polcp03/epwt/01_plan/presentations/assets/photos/IMG_7300.jpg

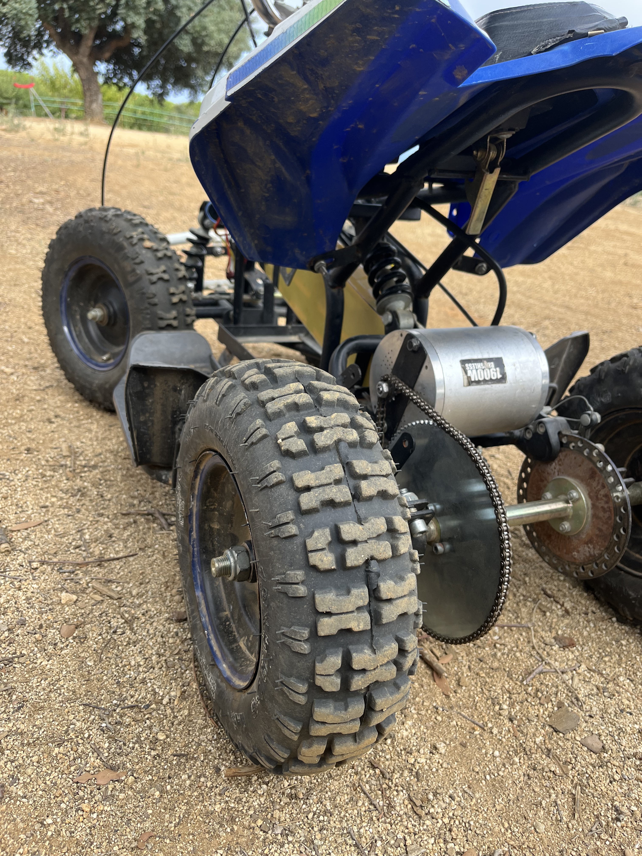
01_plan/presentations/assets/photos/IMG_7300.jpg
