polcp03/epwt/01_plan/presentations/assets/web/vesc_flipsky_1.jpg

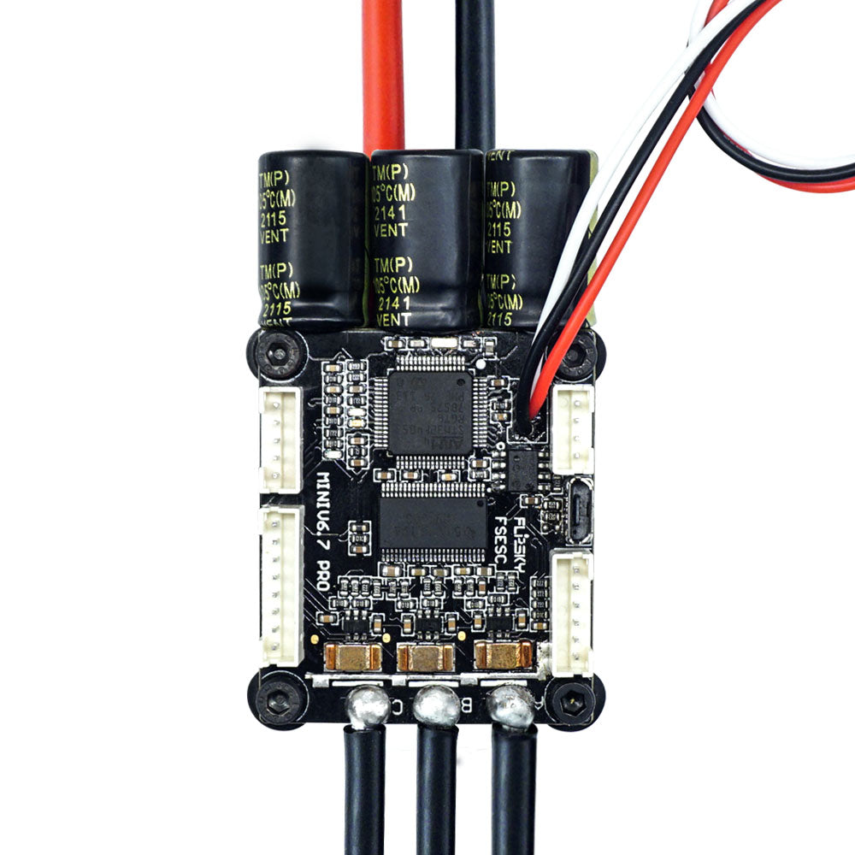
01_plan/presentations/assets/web/vesc_flipsky_1.jpg
