polcp03/epwt/01_plan/C00.md

# C00 — Kickoff con mentores

> [!todo] Pre-ciclo · 2 → 9 septiembre
> **No es un ciclo completo.** Son 8 días (~16 h) antes de las vacaciones.
> **Objetivo:** alinear a los mentores y llegar con algo físico ya medido.
> **Entregable:** reunión de 30 min, martes 8 o miércoles 9.

## Por qué existe este pre-ciclo

Te vas el 10 y vuelves el 27. Meter C01 entero antes es imposible, y partirlo por la
mitad con 2,5 semanas de hueco no es un ciclo: es un ciclo roto.

Así que C00 hace **una sola cosa**: dejar la relación con los mentores montada antes de
irte, para que el 28 de septiembre empieces a trabajar en vez de a organizarte.

> [!tip] Por qué medir algo, aunque sea poco
> Ir con un plan y nada más reproduce justo el patrón que quieres corregir.
> Con **una medida real**, la reunión cambia de "esto es lo que voy a hacer" a
> "esto es lo que ya he empezado". Es otra conversación.

## Plan

### Medir — 3 sesiones `[banco]`
- [x] **Pares de polos = 3** — conteo de pulsos Hall con LED (2026-09-06)
- [ ] ~~Resistencia de fase con multímetro (fase-fase ÷ 2)~~ → **no es viable**, ver abajo
- [x] Anotar en `03_hardware/`, marcado MEDIDO
- [x] **Back-EMF con osciloscopio** → λm = 16,86 mWb MEDIDO (2026-09-07)

> [!warning] Dos correcciones al plan original
> **El método de cogging para pares de polos era erróneo.** Las posiciones de cogging
> las fija la interacción entre ranuras del estátor e imanes del rotor —
> típicamente `mcm(ranuras, polos)` — no `p`. Habría dado un número plausible y falso.
> El conteo de pulsos Hall sí mide `p` por definición: una línea Hall da exactamente
> `p` ciclos por vuelta mecánica.
>
> **El `÷2` de la resistencia fase-fase sí era correcto**, confirmado leyendo el
> firmware: `foc_motor_r` es resistencia por fase. Pero el valor esperado
> (57,6 mΩ entre fases) está por debajo de lo que resuelve un multímetro normal,
> cuyas puntas ya valen 0,1–0,5 Ω. Necesita fuente de corriente conocida o
> miliohmímetro. Aparcada, no descartada.

### Preparar la reunión — 4 sesiones `[dirección]`
- [x] Presentación en inglés — 14 slides tras la poda del 8-sep
- [x] Qué es el proyecto y por qué existe
- [x] El plan: 6 ciclos, de aquí a diciembre, con fechas
- [x] **Qué espero de ellos** (ver abajo — es la slide que más importa)
- [x] Las medidas que ya tengo
- [x] Ensayar en voz alta con Claude de examinador

### Cerrar
- [x] Proponerles el 8 o el 9 → **presentado el 8**
- [ ] Confirmar la cadencia quincenal a partir del 12 de octubre
- [ ] Meter las 6 fechas de review en Google Calendar

## La slide que más importa: qué espero de ellos

Ellos mismos dijeron que aprenderían de ti. Eso está bien, pero puede diluir la
reunión en una charla técnica agradable y sin filo. Hay que pedirles explícitamente
lo que necesitas:

> [!quote] Lo que les pido
> 1. **Que me obliguen a una fecha.** Sin deadline externa, pospongo.
> 2. **Que ataquen mi razonamiento**, no el resultado. ¿La lógica se sostiene?
> 3. **Que detecten cuándo explico mal** porque no lo he entendido.
>
> Lo que NO les pido: validar FOC o control de motores eléctricos. Ese hueco lo cubro
> por otra vía, y decirlo abiertamente evita que se sientan evaluados en un dominio
> que no es el suyo.

## Fuera de alcance

Modelo, Simulink, firmware, campaña completa de medidas. Todo eso es C01, a partir
del 28 de septiembre.

---

## Bitácora

- **2026-09-02** — Infraestructura terminada (PR #2). Calendario aterrizado.
- **2026-09-03** — Detección FOC del VESC ejecutada: R=27,90 mΩ, L=106,49 µH,
  λm=16,07 mWb, sensores Hall. Ver [[motor-parameters]].
  **Hallazgo:** los pares de polos son desconocidos y los datos de mercado se
  contradicen (velocidad → p=3, par → p=4). Se mide con el ratio ERPM/RPM, sin desmontar.
- **2026-09-03** — Deck v1 generado y **rechazado por diseño genérico**. El contenido
  se conserva. Ver `presentations/README.md` para qué hace falta antes de rehacerlo.
- **2026-09-06** — Deck v2 construido y verificado con render (15 slides).
- **2026-09-06** — Auditoría completa del firmware y la configuración del VESC.
  **Resuelto por código:** `foc_motor_r` es resistencia **por fase** (no entre fases),
  y VESC usa las mismas ecuaciones dq que el bloque PMSM de Simulink. Se cierra la
  duda del factor 2 sin tocar el hardware. Parámetros extraídos a
  `04_model/params/` (`motor_params.m`, `vehicle_params.m`, `throttle_params.m`),
  validados en MATLAB.
  **Encontrado:** `si_gear_ratio` estaba en 1 en el equipo (debía ser 8,3636) →
  corregido. El motor no tiene sensor de temperatura, así que sus límites térmicos
  son código muerto → nuevo Riesgo 4 en [[open-questions]].
- **2026-09-06** — **`p = 3` MEDIDO.** Conteo de pulsos Hall con LED, girando la
  corona una vuelta: 25 destellos contra 25,1 predichos. Repetible.
  **Consecuencia:** la contradicción velocidad-vs-par queda resuelta, y en la
  dirección incómoda — los datos de mercado del MY1020/BM1109 **no son de este
  motor**. Con `Kt = 0,0721 N·m/A` harían falta 55 A para los 4 N·m "nominales".
  El deck (slide 10) todavía cuenta la contradicción como abierta: **hay que
  actualizarlo antes de la reunión.**
- **2026-09-08** — **Reunión hecha.** Deck auditado antes de presentar y podado de
  16 a 14 slides con el feedback de Pol. La auditoría encontró dos cosas que se
  habrían preguntado: un hallazgo de cabecera ("velocidad reportada un 28 % alta")
  que **contradecía el XML que citaba**, y una velocidad punta de 41 km/h que no
  existía en ningún sitio del repo. Las dos fuera.
  **Añadido:** la envolvente tenía dos techos y le faltaba el tercero — la
  restricción de tensión, que es la que la cierra en vacío. Las reglas de deck
  quedan en la skill `review-deck`.
  **Abierto:** las notas del VESC (`si_gear_ratio`, `si_motor_poles`) siguen sin
  cuadrar con `MOTOR_1.9.xml`. Pasa a C01 D1–D2, donde es un bloqueante.

## Cierre

**Resultado: la reunión salió bien y el pre-ciclo cumplió su único objetivo.**
Los mentores quedaron enganchados y quieren ver cómo evoluciona. Eso es
exactamente lo que C00 tenía que comprar: una relación abierta antes de las
vacaciones, para que el 28 de septiembre se empiece a trabajar y no a organizarse.

**Feedback de los mentores:** lo que más les gustó **no fueron las medidas, fue
el método** — cómo está organizado el proyecto, el ciclo de dos semanas, la
trazabilidad. Conviene leer eso con cuidado: son ingenieros de térmicos, no
pueden validar FOC, y el deck se lo decía. Lo que sí saben evaluar es si un
ingeniero trabaja de forma defendible. Que hayan mordido justo ahí significa que
el encuadre de la slide 13 funcionó.

**Consecuencia para C01:** si el sistema es lo que valoran, la review del 12 de
octubre tiene que enseñar el sistema **produciendo un resultado**, no el sistema
otra vez. La segunda vez, el método ya no impresiona: los números sí.

> [!todo] Pendiente de rellenar tras confirmar con ellos
> **Fecha de review #1 confirmada:** ___ (propuesta: lunes 12 de octubre)
> **Cadencia quincenal confirmada:** ___
> **Seis fechas en Google Calendar:** ___
>
> Es el único entregable de C00 que puede quedarse a medias, y el que más caro
> sale si se olvida: sin fecha externa, el ciclo pierde su mecanismo.
