polcp03/epwt/01_plan/C01.md

# C01 — Medir el vehículo

> [!todo] Ciclo activo · 28 sep → 11 oct · **Review: lunes 12 de octubre**
> **Objetivo:** cerrar el lado vehículo de `vehicle_params.m`.
> **Entregable:** los parámetros medidos, un coast-down escrito en `07_experiments/`,
> y la review.
> **Pregunta del ciclo:** *¿predice un modelo de fuerzas la deceleración real del quad?*
>
> 14 bloques × 2 h.

## Por qué este objetivo y no el que decía el roadmap

El roadmap ponía C01 como "caracterizar la planta: R, Ke, polos, vehículo".
**La mitad ya está hecha.** En C00 se midieron `p`, `λm`, `R`, `Ld/Lq`, `J` y el
arrastre del rotor, y tres métodos independientes coinciden en `λm` al 0,02 %.
La máquina es hoy la parte mejor caracterizada del quad.

El vehículo es la parte peor. `vehicle_params.m` lo dice sin adornos: el radio de
rodadura es una asunción, la masa una estimación, y `Crr`, `CdA`, `eta_drive` y
`R_int` son `NaN`. Su propio bloque de sensibilidad ordena el trabajo:

| Parámetro | Estado | Error en la aceleración predicha |
|---|---|---|
| `r_roll` | ASSUMED | ±6 % |
| `m_total` | ESTIMATED | ±5 % |
| `Crr` | MISSING | desconocido |
| `eta_drive` | MISSING | desconocido |
| `CdA` | MISSING | débil por debajo de 50 km/h |
| `J_rotor` | MEDIDO ±14 % | **±0,06 %** |

Una hora más en el motor compra menos que un minuto en el chasis. C01 va donde
está el error.

> [!tip] Y hay una razón de reunión, no solo de ingeniería
> Lo que engachó a los mentores en C00 **fue el método, no las medidas**.
> La segunda vez el método ya no impresiona. El 12 de octubre hay que enseñar el
> método **produciendo un número que antes no existía**.

---

## Antes de irte de vacaciones — opcional, 30 min

No es parte del ciclo. Pero son dos cosas que se hacen con el quad delante y sin
ordenador, y si están hechas el 28 de septiembre se arranca midiendo.

- [ ] Pesarte tú y pesar el quad. `m_driver = 72 kg` es una asunción sobre tu
      propia masa; es la más fácil de retirar del repo entero.
- [ ] Fotografiar la corona y el piñón contando dientes, para el archivo.

Si no te apetece, no pasa nada: D3 lo cubre.

---

## Semana 1 · Desbloquear y medir

### D1 — Abrir el ciclo `[dirección]`
- [ ] Leer el cierre de [[C00]]
- [ ] Confirmar las seis fechas de review en Google Calendar (si sigue pendiente)
- [ ] **Reconciliar la contradicción del VESC.** Tres sitios del repo dicen cosas
      distintas del mismo campo: [[C00]] dice que `si_gear_ratio` estaba en 1 y se
      corrigió, [[open-questions]] y `vehicle_params.m` dicen 6,5, y
      `MOTOR_1.9.xml` dice 8,363. **Manda el XML, no las notas.**

> [!danger] D2 bloquea todo lo que viene detrás
> El canal de velocidad del VESC alimenta cada log que C02 va a correlacionar.
> Si sale mal, se mide dos semanas de basura y no se descubre hasta noviembre.

### D2 — Arreglar la configuración del VESC `[banco]`
- [ ] Leer los tres campos en VESC Tool y compararlos con el XML del repo
- [ ] `si_motor_poles`: el XML dice **14**. Con `p = 3` MEDIDO debe ser **6**
- [ ] `si_wheel_diameter`: el XML dice **0,30 m**. Debe ser el diámetro de
      rodadura real, el que salga de D3
- [ ] `si_gear_ratio`: debe ser **8,3636**
- [ ] Re-exportar el XML a `03_hardware/vesc/` y **volver a leerlo** para verificar
- [ ] Corregir las notas del repo para que coincidan con el archivo

> [!question] Antes de tocar nada, calcula el error que arrastras
> La velocidad reportada es
> `(ERPM/(polos/2))/60 · π·d / i`. Con lo que hay hoy en el XML, ¿qué factor sale
> contra la realidad? ¿Y en qué dirección? Si no lo sabes calcular, los logs
> viejos de `06_data/` no se pueden rescatar; si lo sabes, sí.

### D3 — Geometría y masas `[banco]`
- [ ] **Roll-out de `r_roll`**: 10 vueltas de rueda con conductor sentado,
      medir la distancia, `r = D/(10·2π)`. Es el número más apalancado del vehículo
- [ ] Masa del vehículo y masa del conductor, en báscula
- [ ] Batalla
- [ ] **Reparto estático de peso**, con una báscula bajo cada eje

> [!success] Lo que compra el reparto de peso
> Retira el `ASSUMED` de la slide del gear ratio. Hoy el argumento "estoy en el
> límite de agarre" se apoya en μ = 0,75 y 65 % trasero inventados. Con el reparto
> medido, media asunción desaparece — y la otra mitad (μ) se puede acotar el día
> que se mida una aceleración máxima real.

### D4 — El ensayo que decide C02 `[banco]`
- [ ] Coast-down corto registrando por USB. **Hipótesis:** sin par, sin corriente
      de fase, el USB no se corta
- [ ] Si aguanta → C02 se valida sin construir el logger, y C05 se queda donde está
- [ ] Si se corta → osciloscopio en D+/D− y en el raíl de 5 V durante una rampa,
      y el logger pasa a ser un bloqueante real, no una sospecha

> [!danger] Seguridad, antes de cualquier tirada
> Límite de corriente configurado en el VESC · temperatura del pack al terminar ·
> nunca cargar sin supervisión. El motor **no tiene sensor de temperatura**: sus
> límites térmicos son código muerto y no te van a proteger.

### D5 — Campaña de coast-down `[banco]`
- [ ] Superficie plana y conocida, sin viento, marcha libre desde velocidad punta
- [ ] **Ida y vuelta en el mismo tramo**, varias repeticiones
- [ ] Registrar velocidad y tiempo; anotar superficie, presión de neumáticos y
      temperatura

> [!question] Por qué ida y vuelta
> Piénsalo antes de leer la respuesta en ningún sitio: ¿qué dos errores
> sistemáticos cancela promediar las dos direcciones, y por qué ninguno de los dos
> se puede corregir después con los datos de una sola dirección?

### D6 — Inercia del vehículo sobre caballetes `[banco]`
- [ ] El mismo ensayo de deceleración que el rotor, pero con las ruedas montadas
- [ ] La inercia total es ~250× la del rotor, así que la deceleración dura
      minutos y el log a 15 Hz sobra — el problema que arruinó la medida del rotor
      desaparece solo

### D7 — ¿Sirven los datos? `[datos]`
- [ ] Cargar todo en Python y mirarlo **antes de ajustar nada**
- [ ] Si algo hay que repetir, aún quedan cuatro días de banco

> [!warning] Este día existe a propósito
> Es el día para descubrir que un ensayo está mal, no la semana que viene.
> Si sale que todo está bien, se recupera como holgura.

## Semana 2 · Ajustar, escribir y explicar

### D8 — `Crr` y `CdA` del coast-down `[datos]`
- [ ] Modelo: `m·dv/dt = −(Crr·m·g + ½·ρ·CdA·v²)`
- [ ] Ajustar los dos coeficientes a la vez
- [ ] **Dar el intervalo de confianza, no solo el valor**

> [!question] La pregunta que te van a hacer
> Por debajo de 50 km/h domina la rodadura. ¿Cómo de bien está determinado `CdA`
> con estos datos? Un ajuste que da un número sin decir cuánto se lo cree es un
> número que no se puede usar. Y si `CdA` sale mal condicionado, ¿es un fallo del
> ensayo o una propiedad del problema?

### D9 — `eta_drive` y `R_int` `[datos]`
- [ ] Rendimiento de cadena y rodamientos: qué parte de la deceleración es
      transmisión y qué parte es rodadura
- [ ] `R_int` de la batería, de la caída de tensión contra corriente en los logs
- [ ] `R_int` es lo que convierte un límite de corriente en una caída de tensión,
      que es lo que **de verdad** recorta el par disponible

### D10 — EXP-002, escrito `[datos]`
- [ ] Hipótesis → método → datos → conclusión → **limitaciones**
- [ ] En `07_experiments/`, mismo formato que EXP-001

### D11 — Cerrar `vehicle_params.m` `[modelo]`
- [ ] Cada valor con su etiqueta: MEASURED / ESTIMATED / ASSUMED / MISSING
- [ ] Actualizar el bloque de sensibilidad del final: **¿cuál es ahora el
      parámetro más apalancado que sigue sin medir?** Esa pregunta abre C02

### D12 — Deck C01 `[dirección]`
- [ ] Skill `review-deck` — las reglas ya están escritas, no reinventarlas
- [ ] Auditar cada número contra el repo antes de dar el deck por hecho

### D13 — Ensayo `[dirección]`
- [ ] En voz alta, sin apuntes
- [ ] Claude de examinador: la slide peor sostenida, y por qué ese método y no otro

### D14 — Cierre `[dirección]`
- [ ] Rellenar Resultado / Qué aprendí / Qué salió mal
- [ ] Objetivo de C02

**Review: lunes 12 de octubre.**

---

## Fuera de alcance, a propósito

**Simulink.** El modelo longitudinal es C02. Construirlo ahora significaría
alimentarlo con los `NaN` que este ciclo existe para rellenar, y un modelo
parametrizado con asunciones no se puede correlacionar contra nada — solo se
puede ajustar hasta que salga bonito, que es la forma más cara de no aprender.

Lo que cambiaría esto: que D4 salga mal **y** que la campaña de coast-down se
caiga entera. Entonces sobran días y sí tiene sentido adelantar el nivel 1 del
modelo con los parámetros que haya, marcados.

**Firmware, VCU, data logger.** C05, salvo que D4 demuestre que el USB no
aguanta. Ver [[roadmap]].

---

## Bitácora

- **2026-09-08** — Ciclo reescrito tras la review de C00. El objetivo original
  ("caracterizar la planta") estaba a medio hacer antes de empezar: la máquina se
  cerró en C00, así que C01 apunta entero al vehículo.

## Cierre
_(en D14)_ **Resultado:** · **Qué aprendí:** · **Qué salió mal:**
