polcp03/epwt/02_knowledge/README.md

# 02_knowledge — lo que sé, no lo que he leído

Aquí no se copia teoría: la teoría está en los libros y en las lecciones. Aquí queda
**lo que yo sé explicar**, sacado de mis respuestas en los artifacts y corregido.

| Archivo | Qué es | Quién escribe |
|---|---|---|
| `motor-inversor.md` (y uno por tema) | Mis explicaciones, en mis palabras, ya corregidas | Claude copia de mis respuestas; yo reescribo lo que no me suene a mí |
| `errores.md` | Cada fallo que he tenido, con la versión correcta y cuándo volver a preguntármelo | Claude, al corregir |
| `fuentes.md` | Qué libro y qué capítulo para cada tema | Claude |
| `_metodo/` | Herramientas: Git, sesiones de Claude Code | — |

**Cómo se usa:**
1. Contesto en el artifact.
2. Claude corrige (skill `corregir`) y pasa aquí lo que ha quedado bien dicho y los errores.
3. Antes de cada examen, Claude me vuelve a preguntar los errores pendientes de `errores.md`.
   Un error se cierra cuando lo contesto bien **dos veces, en días distintos**.
