polcp03/epwt/01_plan/C02.md

# C02 — Motor + inversor: modelar y saber explicarlo

> [!todo] Ciclo activo · 21 → 30 oct · **Review: viernes 30 de octubre**
> **Pregunta del ciclo:** ¿cómo convierte mi quad 52 V de continua en par en la rueda, y qué lo limita?
> **Solo modelo.** Teoría, dibujos, casos prácticos y exámenes. El vehículo y el VESC no se tocan.
> **Presupuesto (desde 25-oct):** 45–60 min, martes a jueves. Lunes libre (idiomas), viernes de review.

## Dónde está todo

Qué toca cada día: tabla de [START-HERE](../START-HERE.md) y Google Calendar.

| Qué | Dónde |
|---|---|
| L1 · De la batería al par (mar 27) | [lección](https://claude.ai/artifact/F5pNX14PcUEVxtYv8zrwpN) · fuente `C02/L1-bateria-a-par.html` |
| L2 · El campo que gira (mié 28) | [lección](https://claude.ai/artifact/Fxcfde7icEog8iBLodXWTp) · fuente `C02/L2-campo-giratorio.html` |
| L3 · El modelo dq → **pasa a C03** | [lección](https://claude.ai/artifact/ARbJuhTgaTx9dbkfBe4dUh) · fuente `C02/L3-modelo-dq.html` |
| L4 · Tu motor en Simulink → **pasa a C03** | [lección](https://claude.ai/artifact/RYEtSwu3c9AVZad3iw57ZD) · fuente `C02/L4-simulink.html` |
| Examen final de L1+L2 (jue 29) | [C02 · Examen final](https://claude.ai/artifact/2o9NrZ6BgGsVTbg18AX3rZ) · fuente `C02/examen-final.html` |
| Examen original (referencia) | [Examen 1 — Motor eléctrico e inversor](https://claude.ai/code/artifact/764c1e7e-50fc-4bae-b8a6-3b19291b6242), sin cambios |

Formato desde el 25-oct (≈ 55 min): **predice** → **núcleo** de 6 ideas → **laboratorio**
(máx. 2 interactivos) → **criterio** (caso + "encuentra el error") → **cierre** en voz y
"qué no tengo claro". Cada pregunta tiene su cuadro: escribes, guardas y solo entonces se
abre la solución. Las respuestas quedan en la db del artifact (`answers/<lección>-<q>`) y
Claude las corrige. El material largo anterior queda en un anexo plegado; las versiones
viejas, en `C02/_old/`.

## Entregable de la review

1. Explicar de la batería al par sin apuntes.
2. **Número nuevo:** se elige el jueves 29 al acordar las slides.
3. Lo que no entiendo.

~~Modelo dq en Simulink~~ → C03 (replan del 25-oct).

## Después de C02 (dirección, no plan)

C03 inversor + lazo de corriente → data logger → validación con datos reales.
Sin logger no hay datos, y sin datos no se valida. Fechas en [roadmap](roadmap.md).

## Bitácora

- **2026-10-20** — Ciclo abierto. C01 cerrado (review hecha, gustó). Nueva forma de
  trabajar: Pol decide el rumbo, una tarea visible cada 2–3 días, Claude filtra el
  20 % clave de los libros y lo convierte en lecciones con visuales y exámenes.
  Plan y 4 lecciones publicados.
- **2026-10-20 (tarde)** — Revisión completa. Arreglado un fallo que dejaba los gráficos
  en blanco en el móvil (alturas que crecían con la densidad de pantalla). Añadidas una
  figura resumen por lección, un cierre en voz cada día de teoría y un examen final
  propio de C02. Plan reequilibrado a ≤ 90 min por día; el deck lo monta Claude el 29
  por la tarde a partir de la lista de slides acordada.
- **2026-10-21** — Teoría rehecha tras releer Hughes: L1 con las 10 leyes de memoria
  (Ohm/Kirchhoff, Ampère, circuito magnético, Lorentz/Fleming, Faraday, Lenz,
  inductancia, energía, Newton, saturación) y 8 pasos ilustrados; L2 con los 6
  conceptos de alterna (senoide, fasor, RMS, trifásica, √3, polos) y 8 pasos con
  dibujo; L3 con dibujos de Park, circuitos dq y límites. En todas: autocomprobación
  por paso, ejemplo resuelto y otro para ti, y repaso espaciado de la lección anterior.

- **2026-10-25** — Replan. Pol va por L1 cuando tocaba L3: las lecciones eran largas, la
  solución estaba a la vista y nadie le pedía cuentas. Decisiones: máster sentado con el
  PC (se descarta móvil/voz), 45–60 min de martes a jueves, lunes libre, sábado un
  ejercicio, domingo descanso. L1 y L2 rehechas más cortas con cuadros de respuesta que
  ocultan la solución; examen final reducido a L1+L2 (45 min). L3, L4 y teoría de
  control pasan a C03. Todo en Google Calendar, a las 07:00.

## Cierre
_(el 30)_ **Resultado:** · **Qué aprendí:** · **Qué salió mal:**
