polcp03/epwt/01_plan/presentations/assets/photos/IMG_7239.jpg

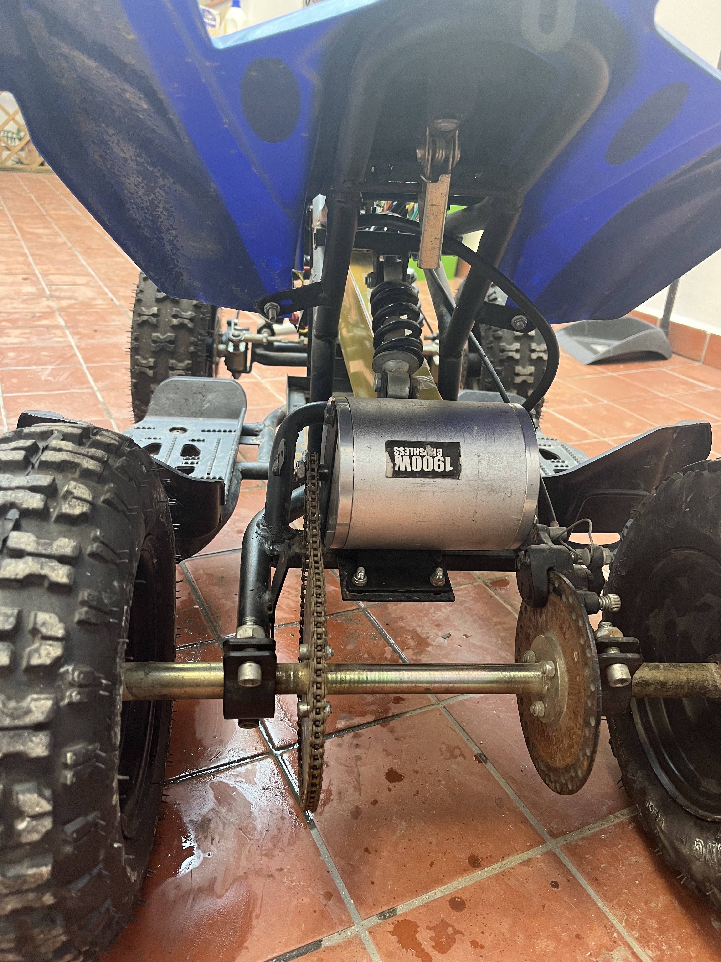
01_plan/presentations/assets/photos/IMG_7239.jpg
