polcp03/epwt/01_plan/presentations/assets/web/vesc_flipsky_2.jpg

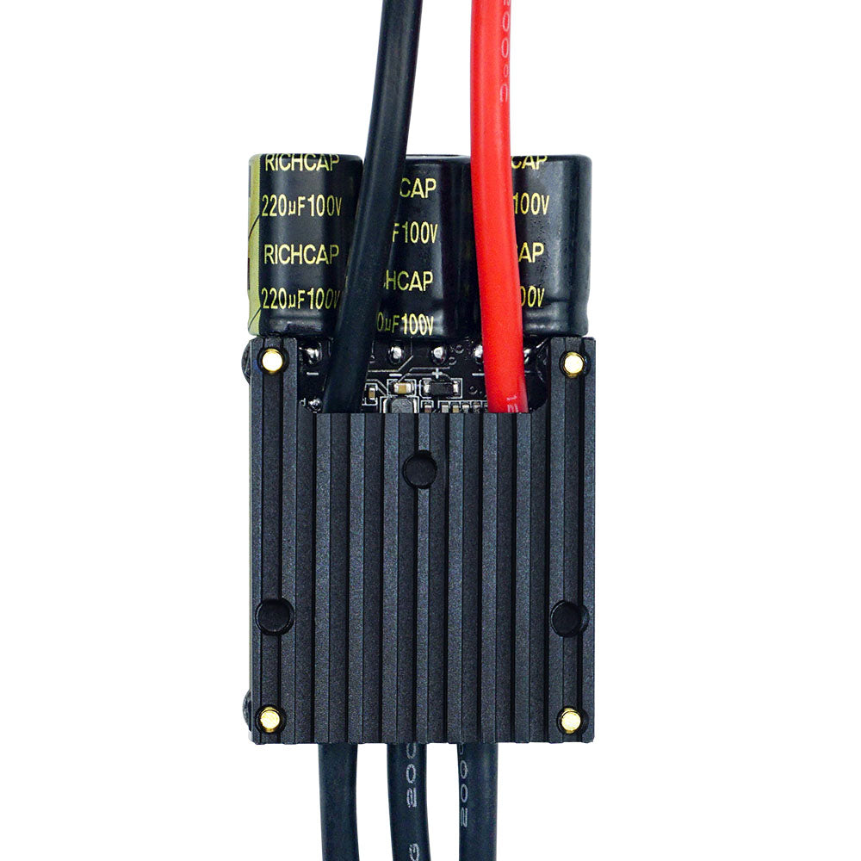
01_plan/presentations/assets/web/vesc_flipsky_2.jpg
