polcp03/epwt/03_hardware/vesc/screenshots/foc-detection_2026-07-29.png

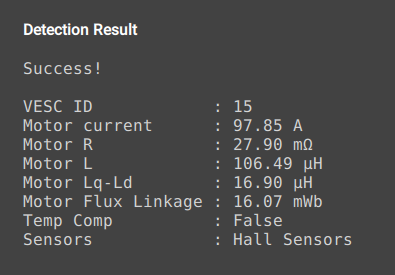
03_hardware/vesc/screenshots/foc-detection_2026-07-29.png
