polcp03/epwt/04_model/results/C01_predictions_table.md

<!-- generated by scripts/run_predictions_L1.m on 2026-10-09 10:38 -->

Nominal at V_oc = 50.0 V, m_total = 110 kg.

| Prediction | Nominal | Band (RSS) | Dominant parameter | V_oc 46 / 54 V |
|---|---|---|---|---|
| Top speed [km/h] | 34.2 | +/- 1.2 | r_roll (65 % of variance) | 31.4 / 36.9 |
| Time 0-25 km/h [s] | 2.8 | +/- 0.5 | mu (60 % of variance) | 3.0 / 2.7 |
| Coast-down 30-5 km/h [s] | 17.2 | +/- 5.6 | Crr (96 % of variance) | 17.2 / 17.2 |
| Speed where 40 A battery limit kicks in [km/h] | 9.0 | +/- 0.6 | R_int (68 % of variance) | 7.9 / 10.2 |

### One-at-a-time detail (low / high end of each range)

| Parameter | Range | Top speed | t 0-25 | Coast 30-5 |
|---|---|---|---|---|
| r_roll | 0.15 - 0.16 | 33.2 / 35.1 | 2.82 / 2.85 | 17.1 / 17.3 |
| Crr | 0.02 - 0.045 | 34.5 / 33.7 | 2.73 / 3.01 | 22.7 / 12.7 |
| CdA | 0.45 - 0.8 | 34.4 / 33.8 | 2.82 / 2.86 | 18.0 / 16.3 |
| eta_drive | 0.9 - 0.97 | 34.1 / 34.2 | 2.97 / 2.79 | 17.3 / 17.2 |
| mu | 0.45 - 0.75 | 34.2 / 34.2 | 3.22 / 2.77 | 17.2 / 17.2 |
| x_cg | 0.55 - 0.75 | 34.2 / 34.2 | 3.02 / 2.77 | 17.2 / 17.2 |
| m_rot_wheels | 2 - 8 | 34.2 / 34.2 | 2.78 / 2.93 | 16.9 / 17.8 |
| R_int | 0.06 - 0.15 | 34.6 / 33.9 | 2.77 / 2.93 | 17.2 / 17.2 |

Grip-limited at launch (nominal): true. Peak battery current (nominal): 40.0 A.
