polcp03/epwt/07_experiments/README.md

# Experiments

Un archivo por experimento: `EXP-001-nombre.md`. Hipótesis -> medida -> conclusión.

- **Pregunta:** qué quiero averiguar
- **Hipótesis:** qué espero que pase, y por qué
- **Método:** cómo lo mido
- **Datos:** qué obtuve (enlace a `data/`)
- **Conclusión:** confirma o refuta
- **Limitaciones:** qué no cubre esto
