polcp03/epwt/06_data/2026-09-07_inercia/2026-09-07_test_inercia.csv

ms_today | input_voltage | temp_mos_max | temp_mos_1 | temp_mos_2 | temp_mos_3 | temp_motor | current_motor | current_in | d_axis_current | q_axis_current | erpm | duty_cycle | amp_hours_used | amp_hours_charged | watt_hours_used | watt_hours_charged | tachometer | tachometer_abs | encoder_position | fault_code | vesc_id | d_axis_voltage | q_axis_voltage | ms_today_setup | amp_hours_setup | amp_hours_charged_setup | watt_hours_setup | watt_hours_charged_setup | battery_level | battery_wh_tot | current_in_setup | current_motor_setup | speed_meters_per_sec | tacho_meters | tacho_abs_meters | num_vescs | ms_today_imu | roll | pitch | yaw | accX | accY | accZ | gyroX | gyroY | gyroZ | gnss_posTime | gnss_lat | gnss_lon | gnss_alt | gnss_gVel | gnss_vVel | gnss_hAcc | gnss_vAcc
40417532 | 52.9 | 35.8 | 0 | 0 | 0 | 0 | 1.36 | 1.46 | 0 | 1.86 | 16448 | 0.949 | 0.032 | 0 | 1.6911 | 0.0005 | 81137 | 81597 | 169.115 | 0 | 15 | -3.186 | 28.751 | 40417316 | 0.032 | 0 | 1.6899 | 0.0005 | 0.881 | 468.745 | -1.46 | -2.23 | 4.413 | 217.417 | 218.652 | 1 | -1 | 0 | 0 | 0 | 0 | 0 | 0 | 0 | 0 | 0 | -1 | 0.00000000 | 0.00000000 | 0.00000000 | 0.00000000 | 0.00000000 | 0.00000000 | 0.00000000
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
