polcp03/epwt/04_model/results/C01_coast_curves.csv

t | nominal | r_roll_lo | r_roll_hi | Crr_lo | Crr_hi | CdA_lo | CdA_hi | eta_drive_lo | eta_drive_hi | mu_lo | mu_hi | x_cg_lo | x_cg_hi | m_rot_wheels_lo | m_rot_wheels_hi | R_int_lo | R_int_hi
0 | 30 | 30 | 30 | 30 | 30 | 30 | 30 | 30 | 30 | 30 | 30 | 30 | 30 | 30 | 30 | 30 | 30
0.1 | 29.7998606498511 | 29.798898450412 | 29.8007445985569 | 29.8337083106026 | 29.7490890336008 | 29.819346754281 | 29.77391870899 | 29.8009210490432 | 29.7994364953958 | 29.7998606498511 | 29.7998606498511 | 29.7998606498511 | 29.7998606498511 | 29.7963112008214 | 29.8066009322906 | 29.7998606498511 | 29.7998606498511
0.2 | 29.6008275621339 | 29.5989126960541 | 29.6025867816201 | 29.6683367692371 | 29.4995627559932 | 29.6394584865262 | 29.5494756425702 | 29.6029390405804 | 29.5999829914692 | 29.6008275621339 | 29.6008275621339 | 29.6008275621339 | 29.6008275621339 | 29.5937681233974 | 29.6142350867619 | 29.6008275621339 | 29.6008275621339
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
