polcp03/epwt/04_model/results/C01_coast_start.csv

v_start_kmh | t_nom | dt_CdA | dt_Crr
15 | 8.03999999999987 | 0.189999999999996 | 3.01999999999994
20 | 11.4899999999998 | 0.389999999999992 | 4.08999999999991
25 | 14.5499999999997 | 0.639999999999986 | 4.8800000000005
30 | 17.2199999999999 | 0.920000000000144 | 5.47000000000086
