polcp03/epwt/04_model/results/C01_envelope.csv

v_kmh | F_wheel | iq | I_bat | F_road | F_grip
0 | 0 | 0 | 0 | 32.373 | 420.849
0 | 0 | 0 | 0 | 32.373 | 420.849
0 | 0 | 0 | 0 | 32.373 | 420.849
0 | 0 | 0 | 0 | 32.373 | 420.849
0 | 0 | 0 | 0 | 32.373 | 420.849
0 | 0 | 0 | 0 | 32.373 | 420.849
0 | 0 | 0 | 0 | 32.373 | 420.849
0 | 0 | 0 | 0 | 32.373 | 420.849
0 | 0 | 0 | 0 | 32.373 | 420.849
0 | 0 | 0 | 0 | 32.373 | 420.849
0 | 0 | 0 | 0 | 32.373 | 420.849
0 | 0 | 0 | 0 | 32.373 | 420.849
0 | 0 | 0 | 0 | 32.373 | 420.849
0 | 0 | 0 | 0 | 32.373 | 420.849
0 | 0 | 0 | 0 | 32.373 | 420.849
0 | 0 | 0 | 0 | 32.373 | 420.849
0 | 0 | 0 | 0 | 32.373 | 420.849
0 | 0 | 0 | 0 | 32.373 | 420.849
0 | 0 | 0 | 0 | 32.373 | 420.849
0 | 0 | 0 | 0 | 32.373 | 420.849
0 | 0 | 0 | 0 | 32.373 | 420.849
0 | 0 | 0 | 0 | 32.373 | 420.849
0 | 0 | 0 | 0 | 32.373 | 420.849
0 | 0 | 0 | 0 | 32.373 | 420.849
0 | 0 | 0 | 0 | 32.373 | 420.849
0 | 0 | 0 | 0 | 32.373 | 420.849
0 | 0 | 0 | 0 | 32.373 | 420.849
0 | 0 | 0 | 0 | 32.373 | 420.849
0 | 0 | 0 | 0 | 32.373 | 420.849
0 | 0 | 0 | 0 | 32.373 | 420.849
0 | 0 | 0 | 0 | 32.373 | 420.849
0 | 0 | 0 | 0 | 32.373 | 420.849
0 | 0 | 0 | 0 | 32.373 | 420.849
0 | 0 | 0 | 0 | 32.373 | 420.849
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
