polcp03/epwt/04_model/results/C01_oat.csv

param | vtop_lo | vtop_hi | t025_lo | t025_hi | tcst_lo | tcst_hi
r_roll | 33.174077118365 | 35.1318280749878 | 2.81598472145789 | 2.85337141689965 | 17.1399999999999 | 17.2899999999999
Crr | 34.473465432653 | 33.6761519402646 | 2.73266758162944 | 3.01371217594468 | 22.6900000000007 | 12.6899999999998
CdA | 34.399318490011 | 33.8445572729282 | 2.8194305253054 | 2.86086170533314 | 18.01 | 16.2999999999997
eta_drive | 34.0538602382112 | 34.1990306082908 | 2.96654949341254 | 2.78913031987701 | 17.3199999999999 | 17.1799999999999
mu | 34.1597588386619 | 34.1597588386619 | 3.22094231549211 | 2.77081587330827 | 17.2199999999999 | 17.2199999999999
x_cg | 34.1597588386619 | 34.1597588386619 | 3.02005254931557 | 2.77081587330827 | 17.2199999999999 | 17.2199999999999
m_rot_wheels | 34.1597588386619 | 34.1597588386619 | 2.78462016862827 | 2.93085095329062 | 16.9199999999998 | 17.82
R_int | 34.5712030661931 | 33.8757794886776 | 2.77233151779194 | 2.92721387708987 | 17.2199999999999 | 17.2199999999999
NOMINAL | 34.1597588386619 | 34.1597588386619 | 2.84004286606908 | 2.84004286606908 | 17.2199999999999 | 17.2199999999999
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
