polcp03/epwt/04_model/results/back_emf_resultado.png

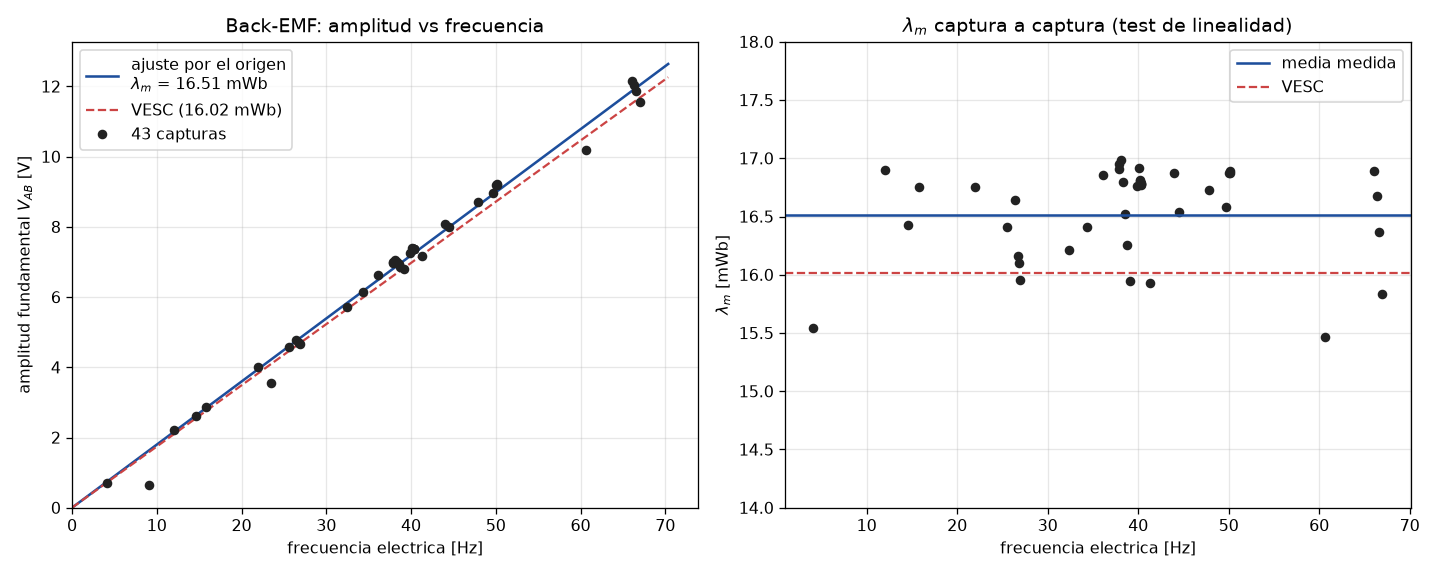
04_model/results/back_emf_resultado.png
