polcp03/epwt/04_model/results/back_emf_txt.png

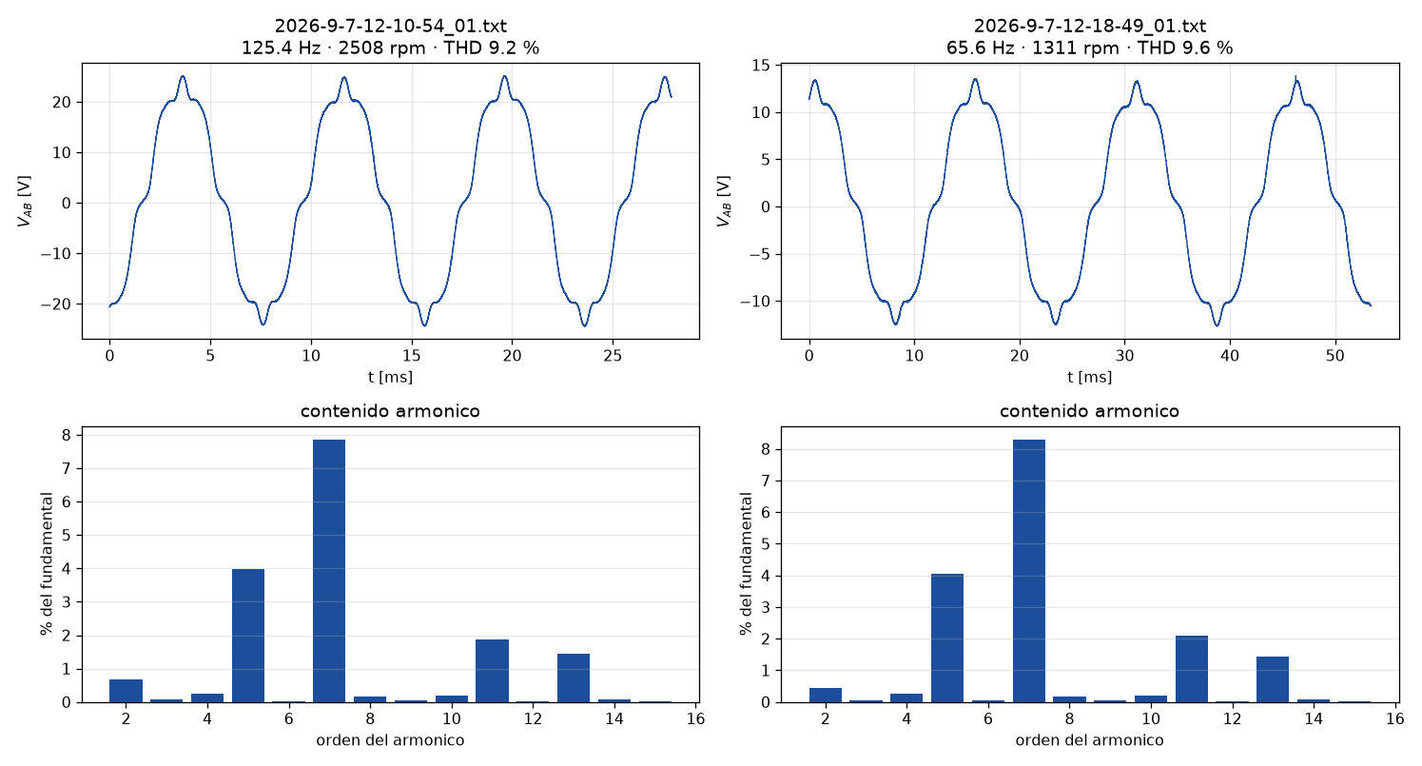
04_model/results/back_emf_txt.png
