polcp03/epwt/04_model/results/backemf_pasos.png

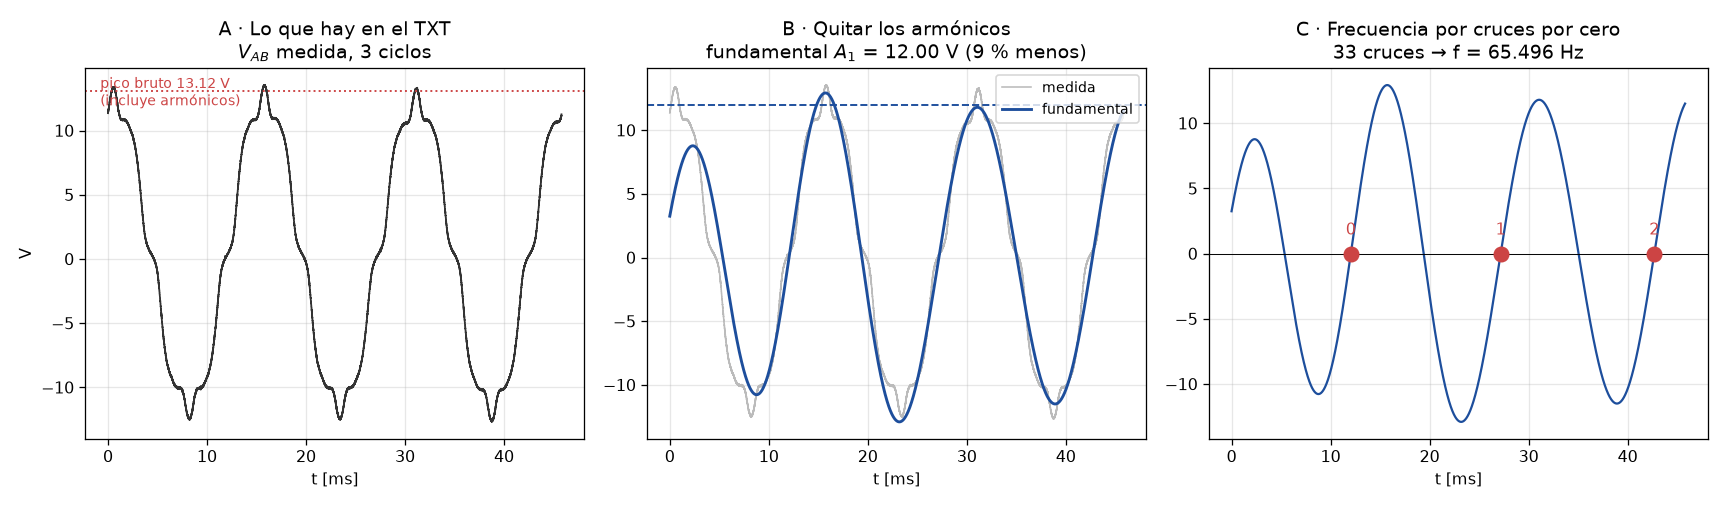
04_model/results/backemf_pasos.png
