polcp03/epwt/04_model/results/backemf_picos_diagnostico.png

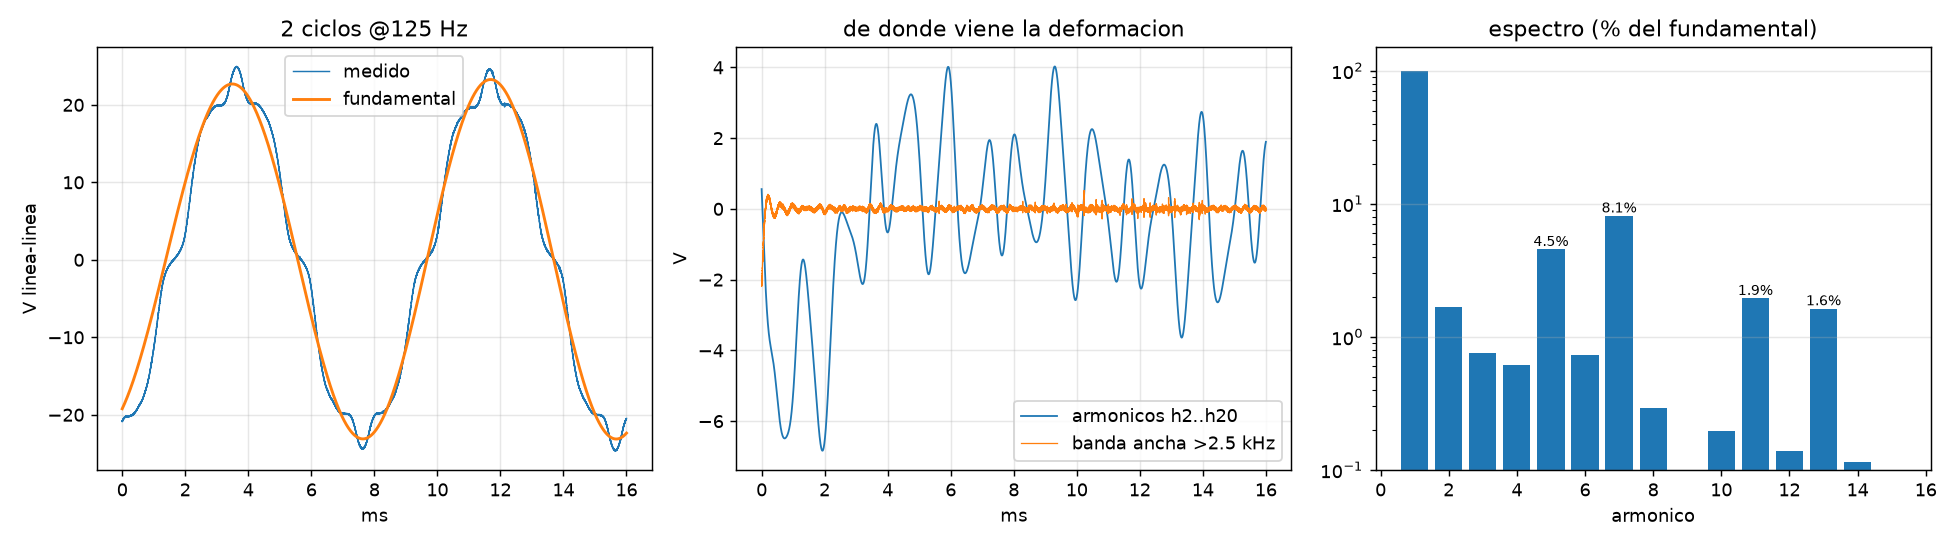
04_model/results/backemf_picos_diagnostico.png
