polcp03/epwt/04_model/results/C01_model_L2_top.png

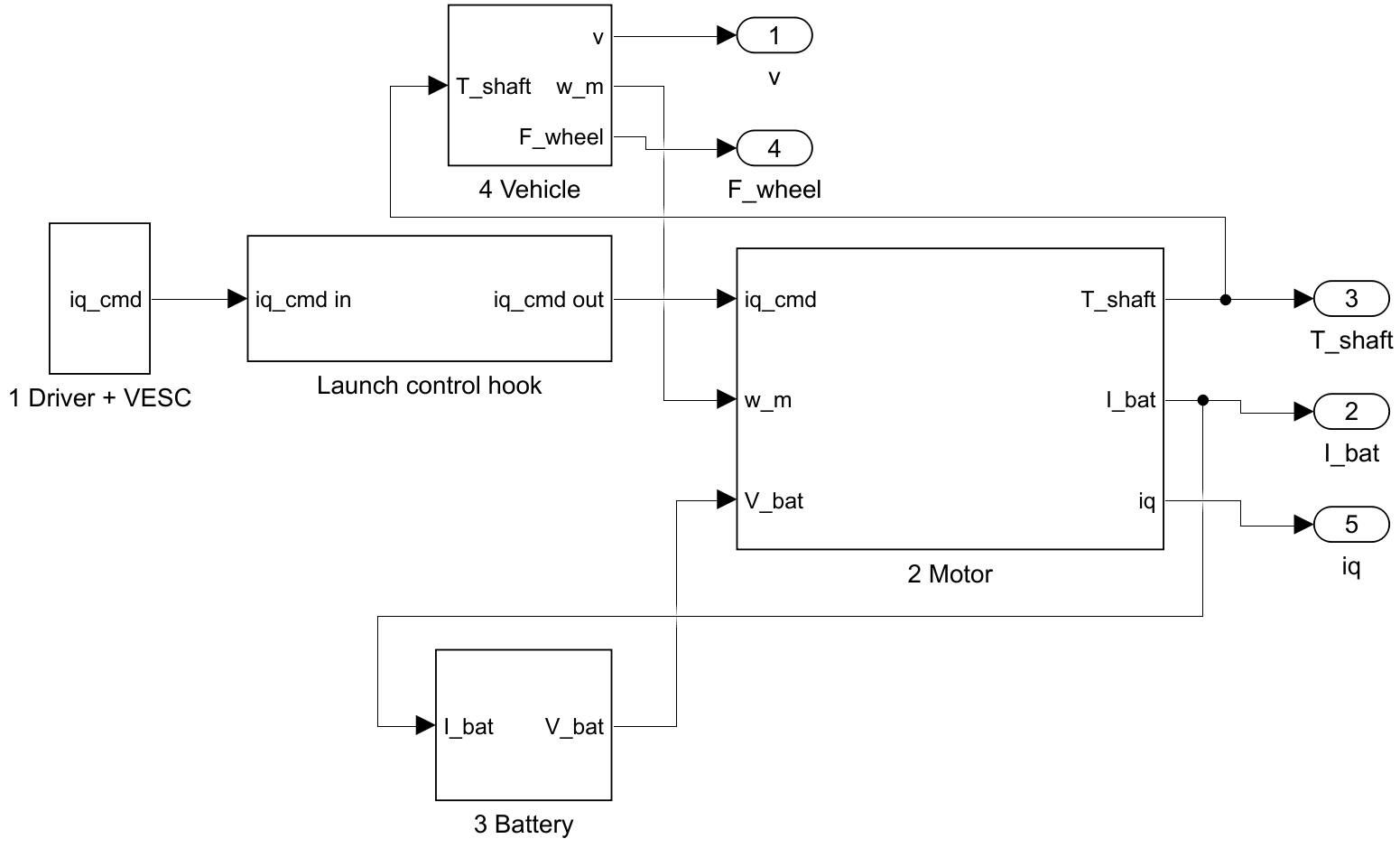
04_model/results/C01_model_L2_top.png
