polcp03/epwt/04_model/results/inercia_raw.png

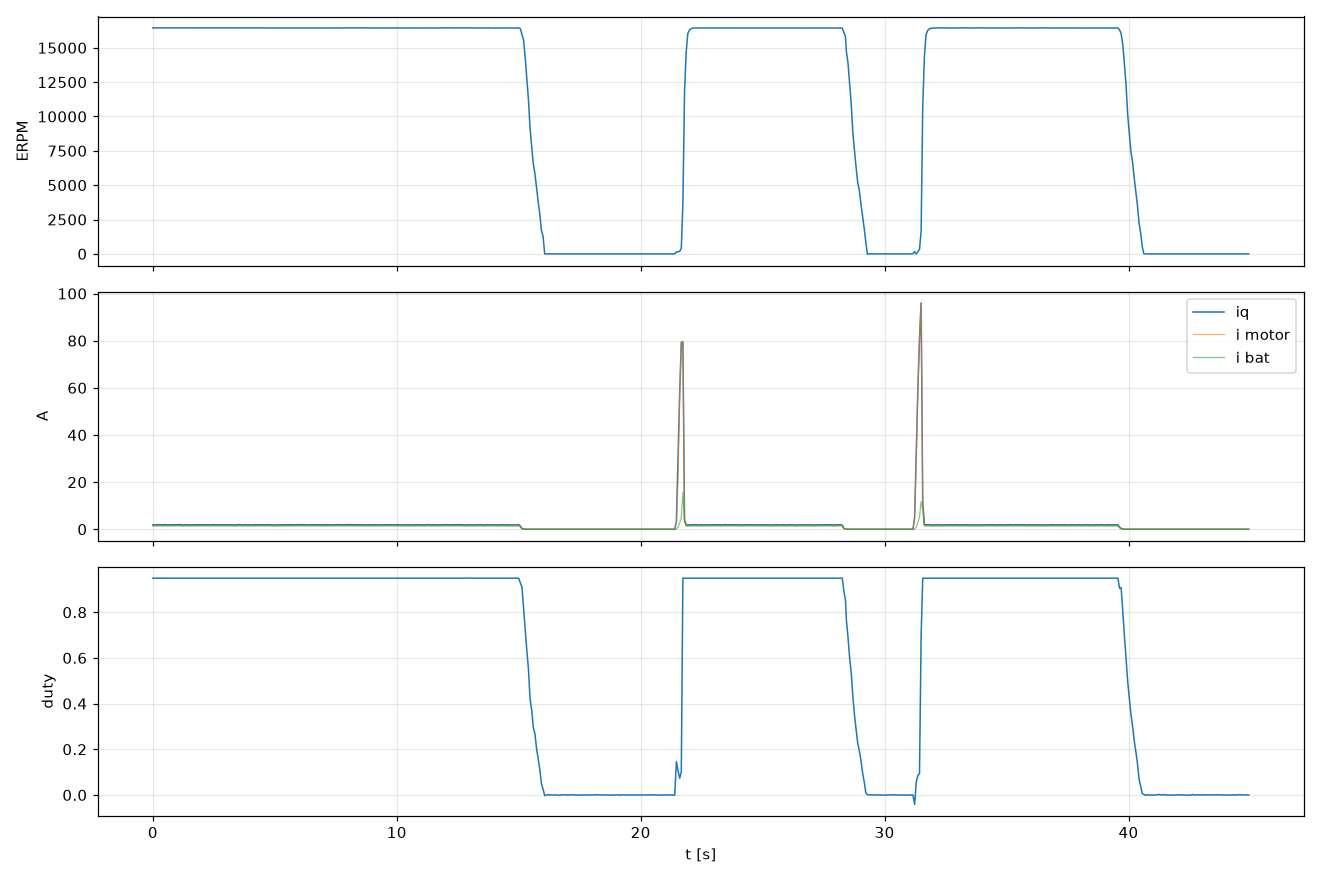
04_model/results/inercia_raw.png
