polcp03/epwt/04_model/results/inercia_resultado.png

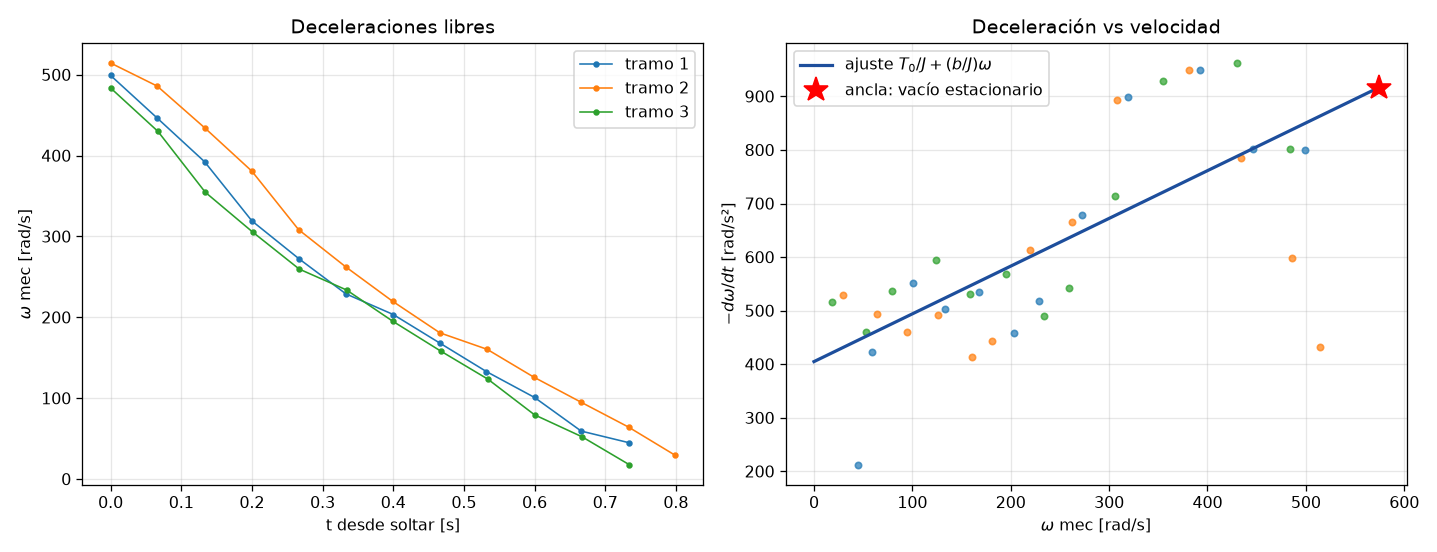
04_model/results/inercia_resultado.png
