polcp03/epwt/(commit log)

2026-08-20 Initial project scaffolding: knowledge structure and harness context
    Set up the traceability skeleton (requirements, tasks, experiments,
    decisions, docs) as versioned Markdown, plus the original AI-first
    harness architecture proposal for reference.
2026-09-01 Connect Simulink to the coding agent over MCP
    Add the MathWorks Simulink Agentic Toolkit on top of the MATLAB MCP Server so
    the agent can read model structure, query parameters and run simulations in a
    live MATLAB session.
    Scope is deliberately read-and-simulate. The toolkit also exposes tools that
    create and wire blocks; rule 4 in 04_model/CLAUDE.md rules them out unless asked
    for explicitly, because a .slx is binary and an agent's edits cannot be reviewed
    in a diff.
    .mcp.json is committed even though its paths are machine-specific: it documents
    the setup. README explains how to regenerate it rather than edit it. The MCP
    approval in .claude/settings.local.json stays untracked — it is a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
2026-09-08 Add back-EMF harmonic diagnostic and deck figure rule (#3)
    The open-circuit back-EMF capture showed spiky peaks that a mentor
    attributed to phase inductance. With the motor physically disconnected
    from the VESC the phase current is identically zero, so L*di/dt cannot
    contribute; the deviation had to come from somewhere else.
    Analysis of the 5 MS/s raw capture confirms it is spatial harmonics of
    the winding, not a transient:
    h7 8.1 % h5 4.5 % h11 1.9 % h13 1.6 % of fundamental
    everything above 2.5 kHz: 0.37 % (0.06 V RMS)
    The fast-band energy is flat across the cycle (0.033 V near the zero
    crossing vs 0.040 V near the peak) with no resonant line, which rules
    out a di/dt even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
2026-09-08 Version the VESC configuration as hardware source of truth (#4)
    * Version the VESC configuration as hardware source of truth
    The VESC config was living only inside the tool's own storage, which
    means the motor and app parameters the whole model depends on had no
    history and could not be diffed after a re-detection.
    Adds:
    - MOTOR_1.9.xml / MOTOR_1.9_app.xml -- the active motor and app
    configuration exported from VESC Tool.
    - reference/{mcconf,appconf}_default.h -- upstream defaults, kept next
    to the config so any parameter can be read against its factory value
    without opening the 219 MB firmware tree.
    - screenshots/ -- the 2026-07-29 FOC detection run and the 2026-08-10
    USB serial f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
    [2026-09-07_test_inercia.csv, MOTOR_1.9.xml, MOTOR_1.9_app.xml]
2026-10-25 Rescue C01/C02 work, reorganise repo, close the learning loop (#5)
    * Re-export VESC config with pole count fixed (14 -> 6)
    si_motor_poles now matches the measured p = 3. The stale si_gear_ratio = 6.5
    note is closed: every export already read 8.363.
    * Add C01 longitudinal model (L1, L2) and frozen predictions
    Models are built from scripts so every block and wire shows up in the diff.
    L2 regroups L1 into four subsystems with two empty hooks (load transfer,
    launch control) for Pol to fill. Predictions are frozen before any test.
    * Add C01 review deck, exam and Pol's deck feedbac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
    [C01_accel_curves.csv, C01_coast_curves.csv, C01_coast_start.csv, C01_envelope.csv, C01_oat.csv, MOTOR_1.9.xml, MOTOR_1.9_app.xml]
2026-10-30 Unir ePWT: el quad entra como epwt/ y comparte contexto con la carrera
    - epwt/ conserva su CLAUDE.md, que manda solo dentro de esa carpeta
    - Skills leccion, corregir y review-deck y .mcp.json pasan a la raíz
    - BOOKS/ única en la raíz; entorno Python en epwt/.venv con requirements.txt
    - carrera/logros.md: lo demostrado en cada ciclo, de donde sale el CV
    - CLAUDE.md, INICIO.md y DECISIONES.md explican el cambio
2026-10-30 ePWT: el repositorio antiguo es público; no se archiva sin decidirlo
2026-10-30 Rename epwt/ to PROJECT_ePWT/ (folder name only, no content change)
    The subtree trailers below tell `git subtree split` that the public
    portfolio (polcp03/epwt) continues from its current head, so it keeps
    growing by fast-forward instead of starting a new history.
    git-subtree-dir: PROJECT_ePWT
    git-subtree-mainline: 66e724441dc0a015f0c3fecf7e92770fe4b29245
    git-subtree-split: 7dce799dee96bad7670f3f87b668530acc80ca39
